b-vineeth/Prosthetic-Hand-Design/Milestone #2.docx

Milestone 2:

1. Solid Modelling of gears (may be diff. from milestone 1)

2. Print gears in Epic Lab

3. Submit photo of all gears in a JPEG file
