b-vineeth/Prosthetic-Hand-Design/Others/Prosthetic Frame Side View Dimensions.png

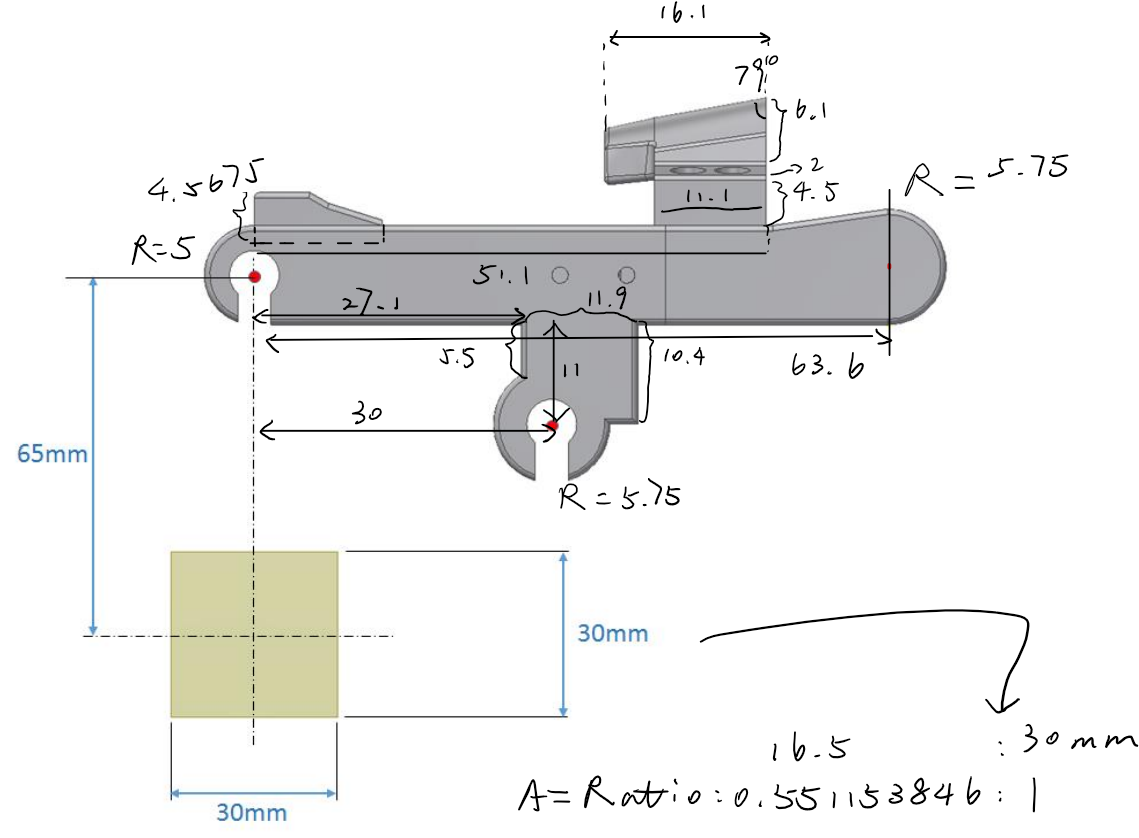
Others/Prosthetic Frame Side View Dimensions.png
