b-vineeth/Prosthetic-Hand-Design/Others/Prosthetic Frame Top View Dimensions.png

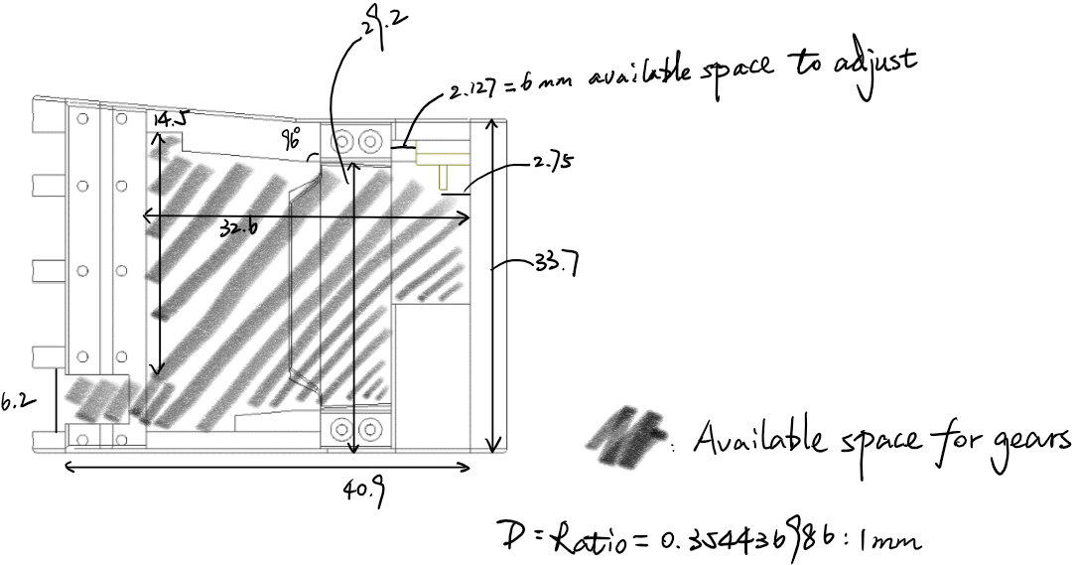
Others/Prosthetic Frame Top View Dimensions.png
