b-vineeth/Prosthetic-Hand-Design/CAD Files/90480A009_LOW-STRENGTH STEEL HEX NUT.STEP

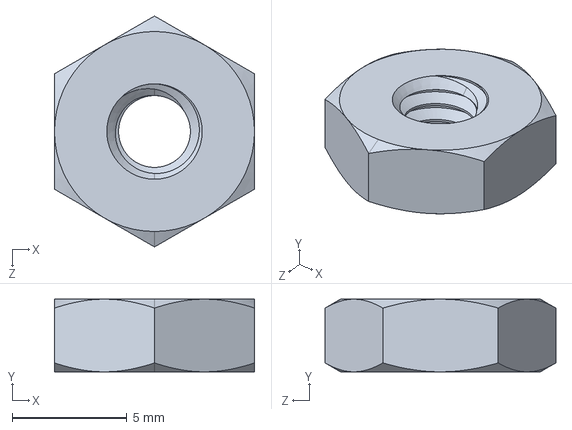
[picture p23: CAD file, 2021-11-05]
CAD Files/90480A009_LOW-STRENGTH STEEL HEX NUT.STEP
8.73 x 3.18 x 10.1 mm
