b-vineeth/Prosthetic-Hand-Design/CAD Files/91565A838_LOW-STRENGTH STEEL THREADED ROD.STEP

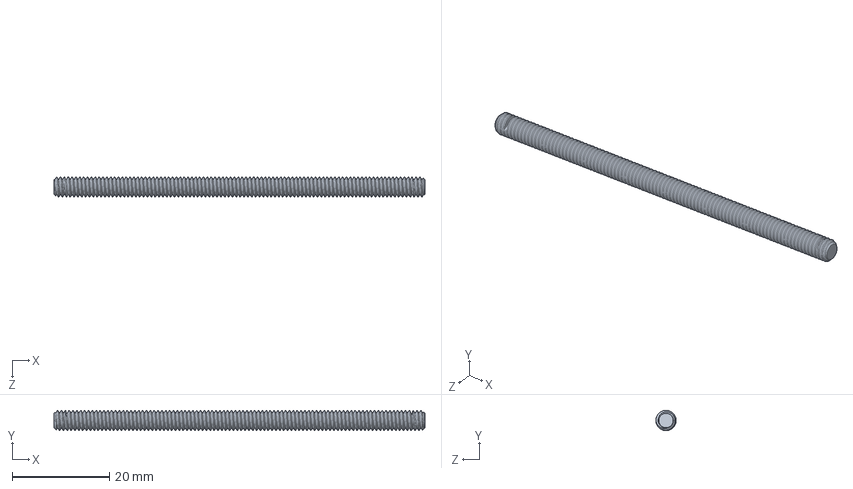
[picture p24: CAD file, 2021-11-05]
CAD Files/91565A838_LOW-STRENGTH STEEL THREADED ROD.STEP
76.2 x 4.16 x 4.17 mm
