b-vineeth/Prosthetic-Hand-Design/Drawings/2. Gears.pdf

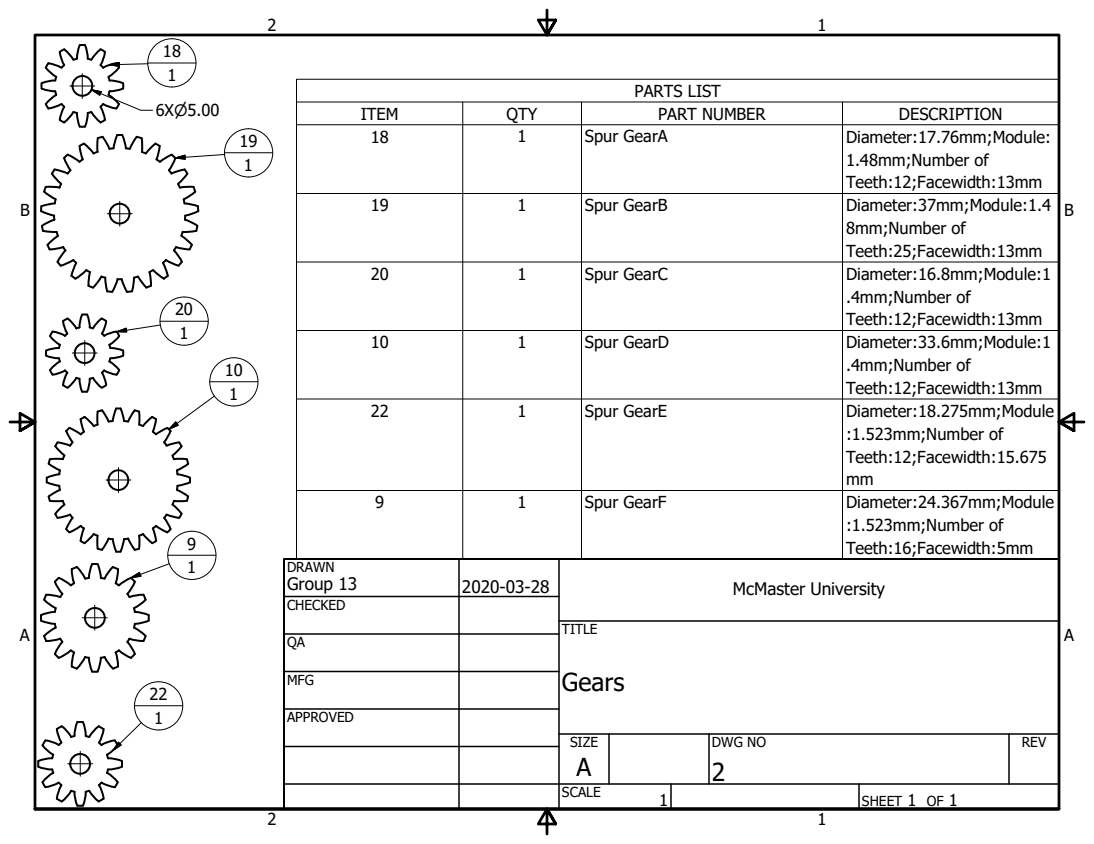
[picture p25: page 1]
PARTS LIST; ITEM; QTY; PART NUMBER; DESCRIPTION; Diameter:24.367mm;Module :1.523mm;Number of Teeth:16;Facewidth:5mm; Spur GearF; SHEET 1 OF 1; DRAWN; CHECKED; MFG; APPROVED; Group 13; DWG NO 2; TITLE; Gears; SIZE A; SCALE; McMaster University; REV

18 | 1 | Spur GearA | Diameter:17.76mm;Module: 1.48mm;Number of Teeth:12;Facewidth:13mm

19 | 1 | Spur GearB | Diameter:37mm;Module:1.4 8mm;Number of Teeth:25;Facewidth:13mm

20 | 1 | Spur GearC | Diameter:16.8mm;Module:1 .4mm;Number of Teeth:12;Facewidth:13mm

10 | 1 | Spur GearD | Diameter:33.6mm;Module:1 .4mm;Number of Teeth:12;Facewidth:13mm

22 | 1 | Spur GearE | Diameter:18.275mm;Module :1.523mm;Number of Teeth:12;Facewidth:15.675 mm
