b-vineeth/Prosthetic-Hand-Design/Drawings/3. Combined Brackets 1_3.pdf

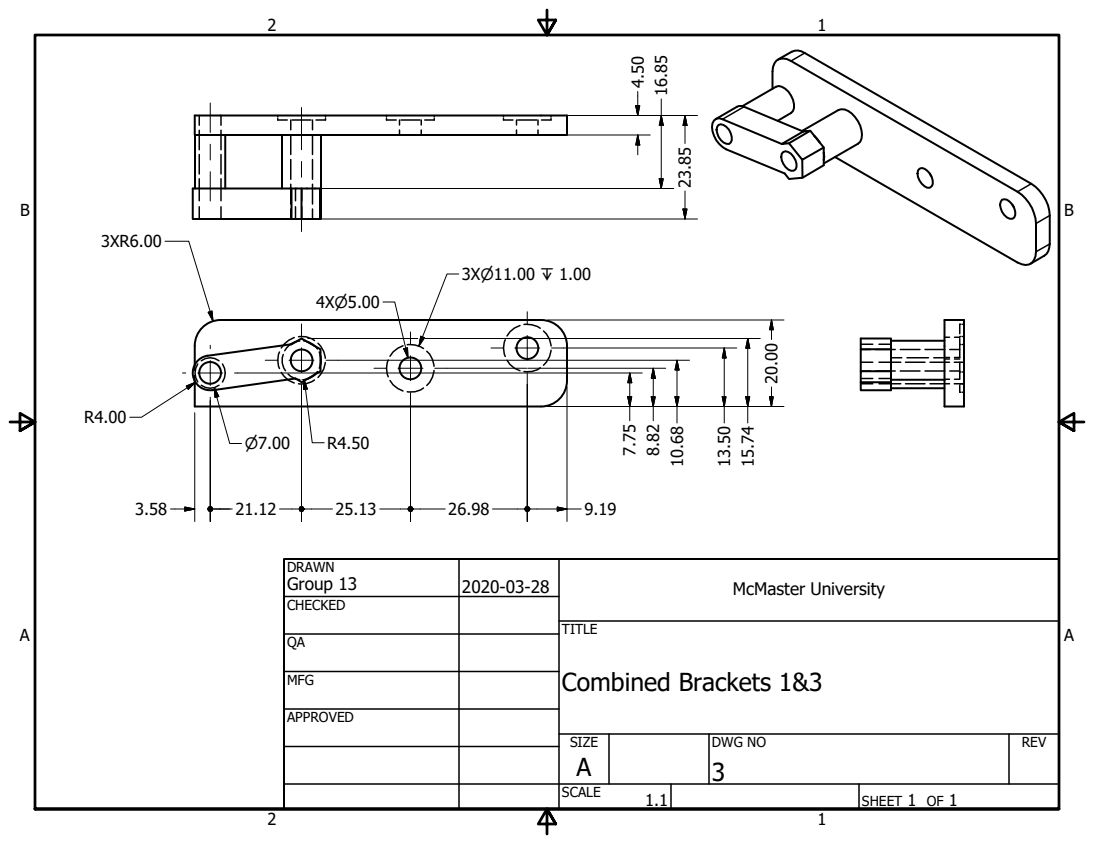
[picture p26: page 1]
DRAWN; CHECKED; MFG; APPROVED; Group 13; TITLE; Combined Brackets 1&3; McMaster University

SIZE A | | DWG NO 3 | REV

SCALE 1.1 | | SHEET 1 OF 1
