b-vineeth/Prosthetic-Hand-Design/Drawings/4. Bracket 2.pdf

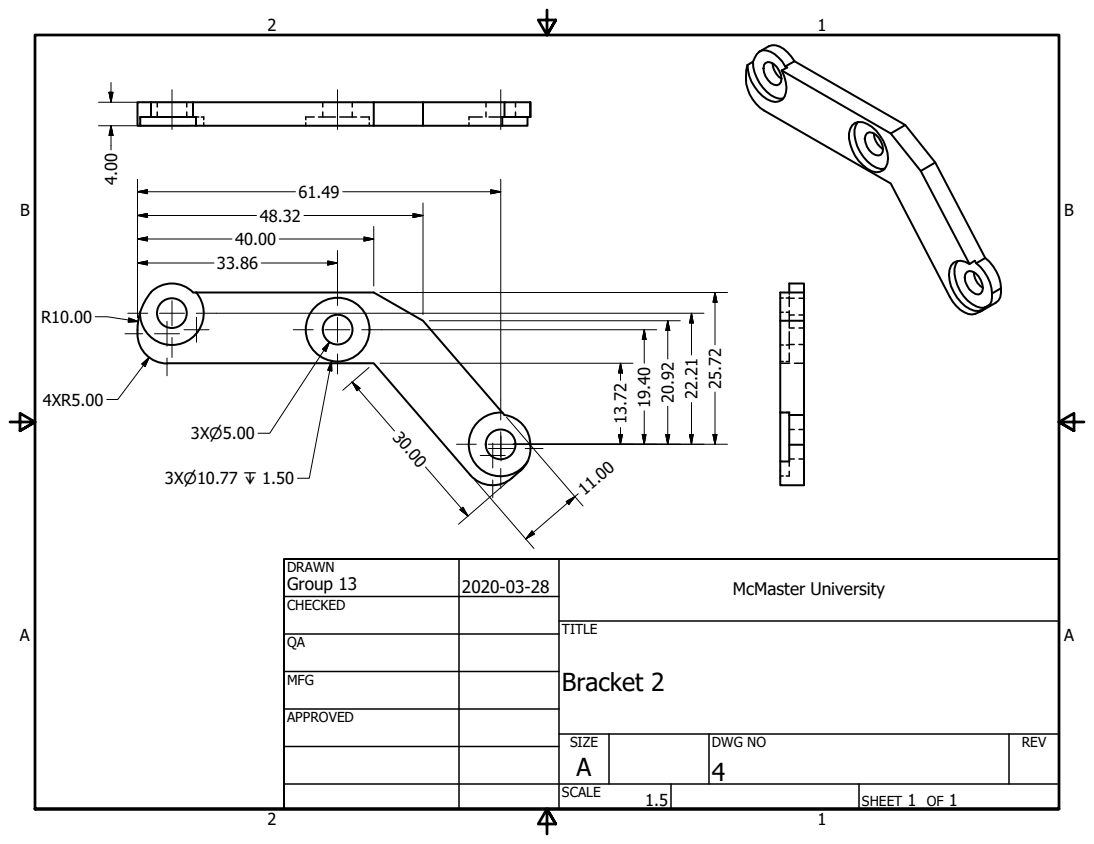
[picture p27: page 1]
SHEET 1 OF 1; DRAWN; CHECKED; MFG; APPROVED; Group 13; DWG NO 4; TITLE; Bracket 2; SIZE A; SCALE; McMaster University; REV
