b-vineeth/Prosthetic-Hand-Design/Drawings/5. Bracket 4.pdf

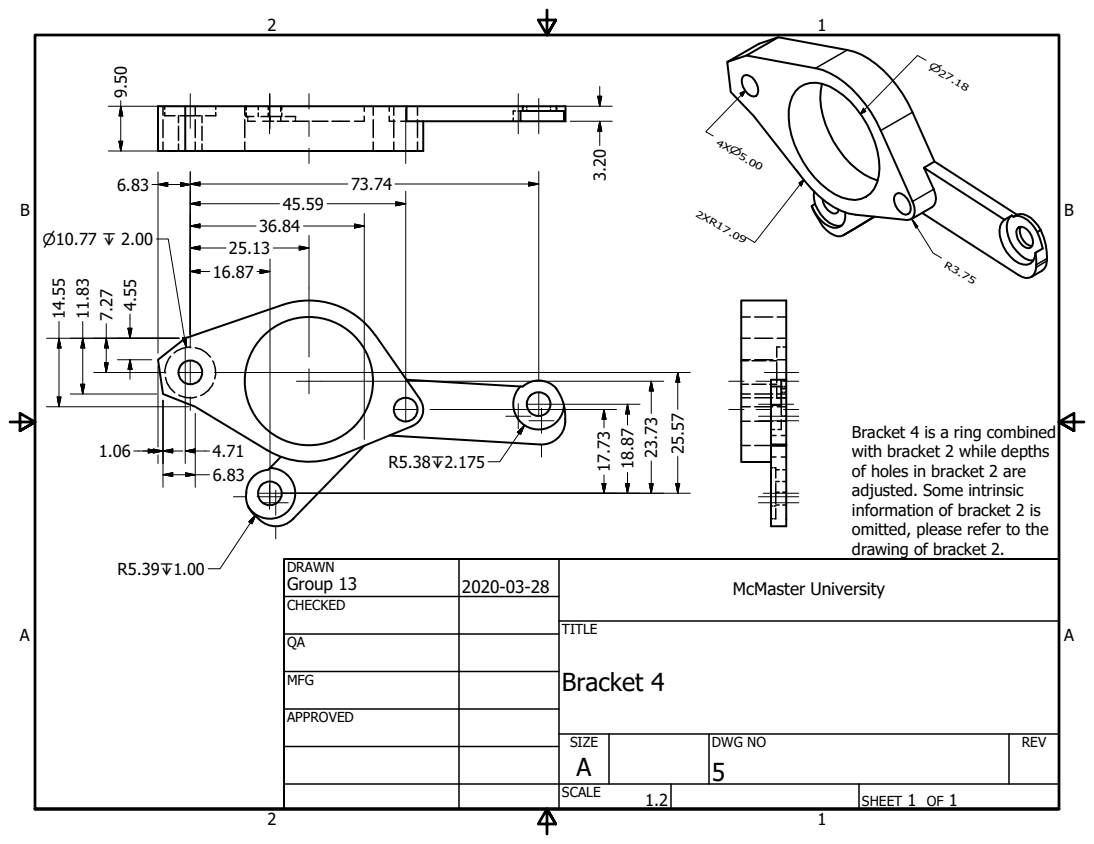
[picture p28: page 1]
SHEET 1 OF 1; DRAWN; CHECKED; MFG; APPROVED; Group 13; DWG NO 5; TITLE; Bracket 4; SIZE A; SCALE; McMaster University; REV

Bracket 4 is a ring combined
with bracket 2 while depths
of holes in bracket 2 are
adjusted. Some intrinsic
information of bracket 2 is
omitted, please refer to the
drawing of bracket 2.
