b-vineeth/Prosthetic-Hand-Design/Drawings/6. Gear G1_G2.pdf

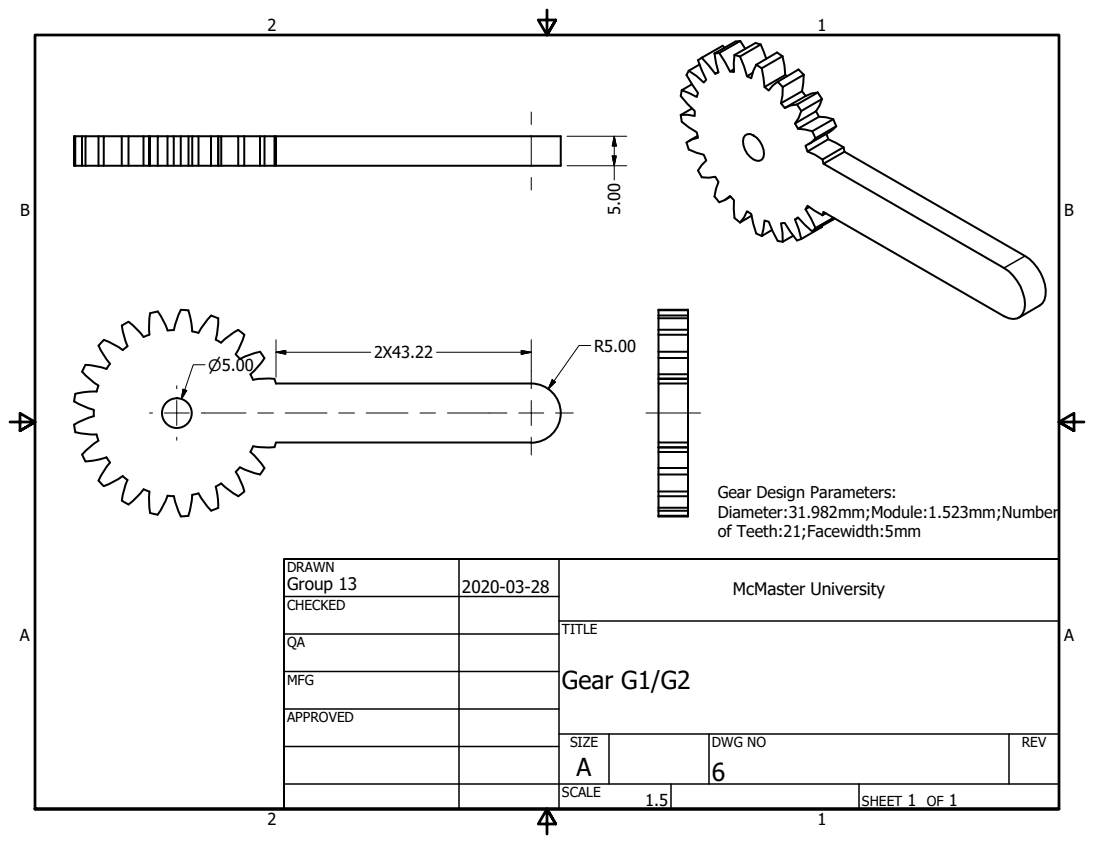
[picture p29: page 1]
SHEET 1 OF 1; DRAWN; CHECKED; MFG; APPROVED; Group 13; DWG NO 6; TITLE; Gear G1/G2; SIZE A; SCALE; McMaster University; REV

Gear Design Parameters:
Diameter:31.982mm;Module:1.523mm;Number
of Teeth:21;Facewidth:5mm
