b-vineeth/Prosthetic-Hand-Design/Drawings/Combined Brackets 1_3.pdf

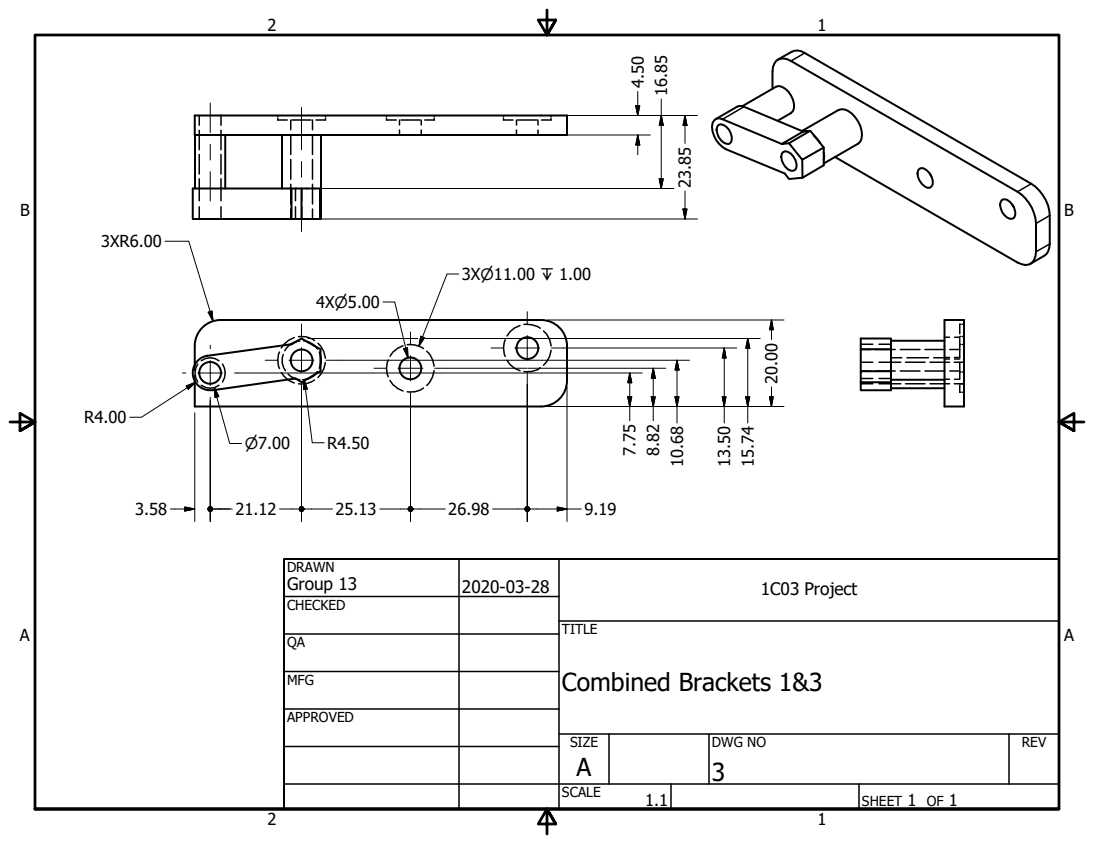
[picture p30: page 1]
DRAWN; CHECKED; MFG; APPROVED; Group 13; TITLE; Combined Brackets 1&3; 1C03 Project

SIZE A | | DWG NO 3 | REV

SCALE 1.1 | | SHEET 1 OF 1
