b-vineeth/Prosthetic-Hand-Design/Resources/Rod Dimensions.PDF

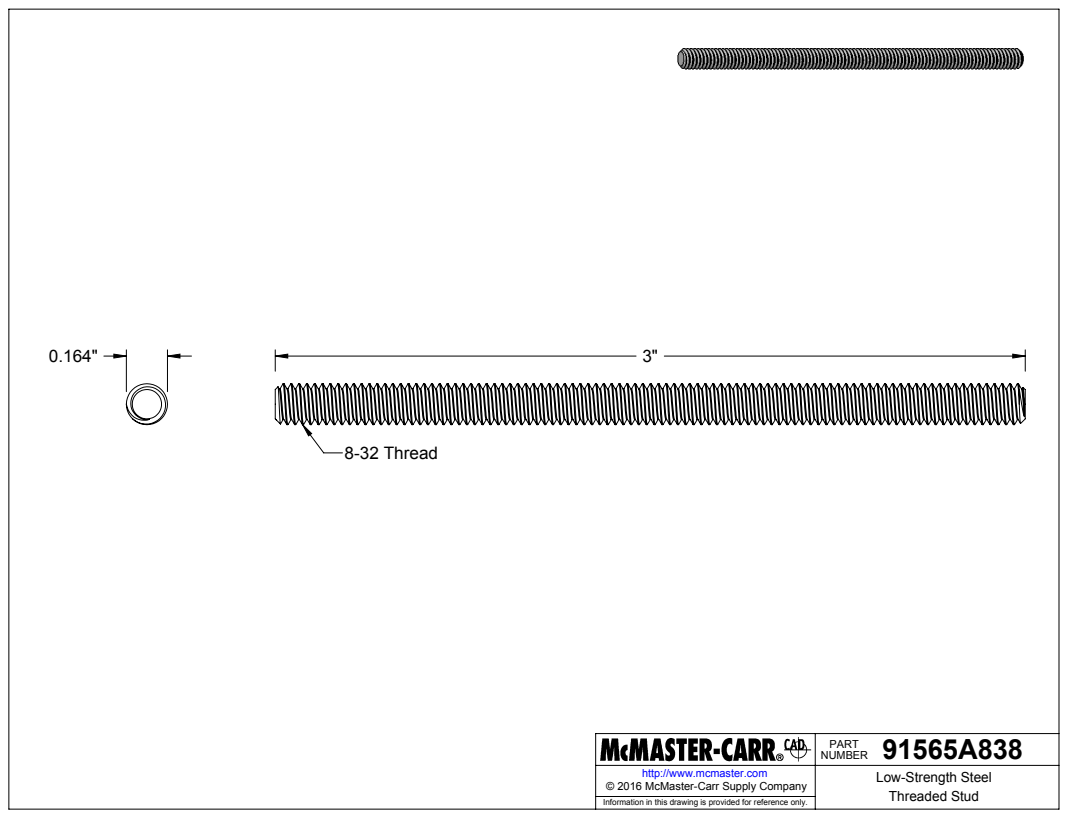
[picture p31: page 1]
8-32 Thread

91565A838 PART NUMBER

http://www.mcmaster.com | Low-Strength Steel Threaded Stud © 2016 McMaster-Carr Supply Company

Information in this drawing is provided for reference only.
