b-vineeth/Prosthetic-Hand-Design/Drawings/1. Assembly Drawing.pdf

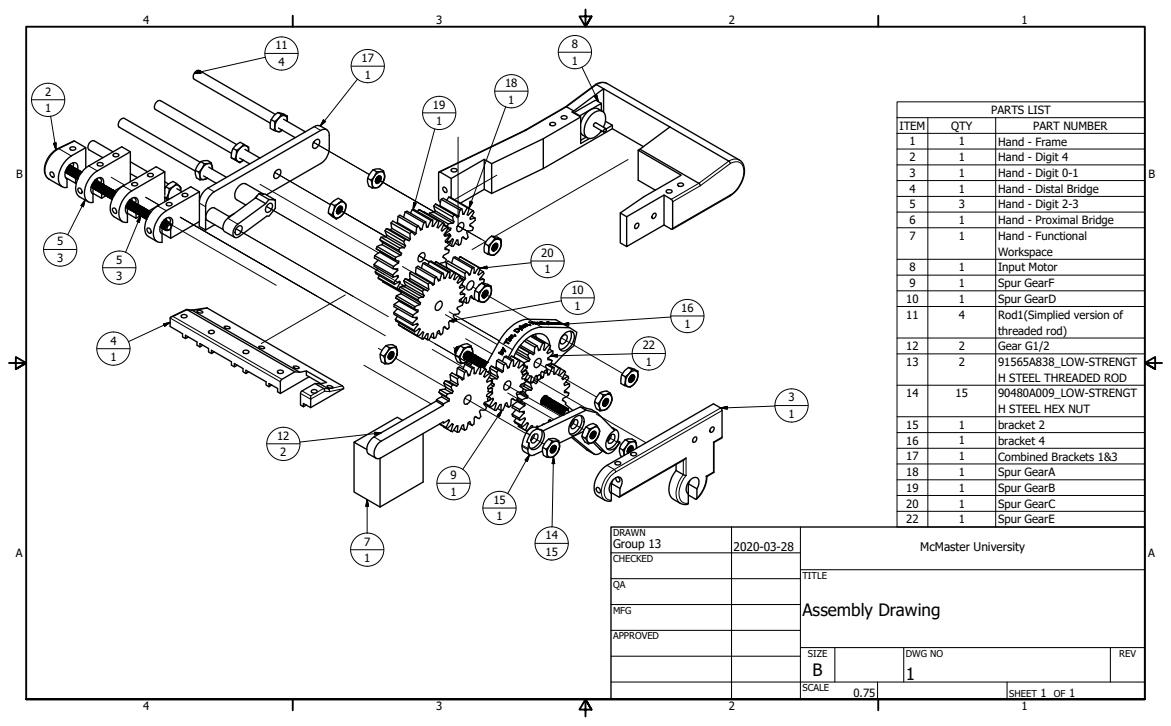
[picture p32: page 1]
bly

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

1 2 | 2 | G e a r G 1 / 2
1 3 | 2 | 9 1 5 6 5 A 8 3 8 _ L O W -S T R E N G T H S T E E L T H R E A D E D R O D

1 5 | 1 | b r a c k e t 2
1 6 | 1 | b r a c k e t 4
1 7 | 1 | C o m b i n e d B r a c k e t s 1 & 3
1 8 | 1 | S p u r G e a r A
1 9 | 1 | S p u r G e a r B
2 0 | 1 | S p u r G e a r C
