b-vineeth/Prosthetic-Hand-Design/Drawings/bracket 2.pdf

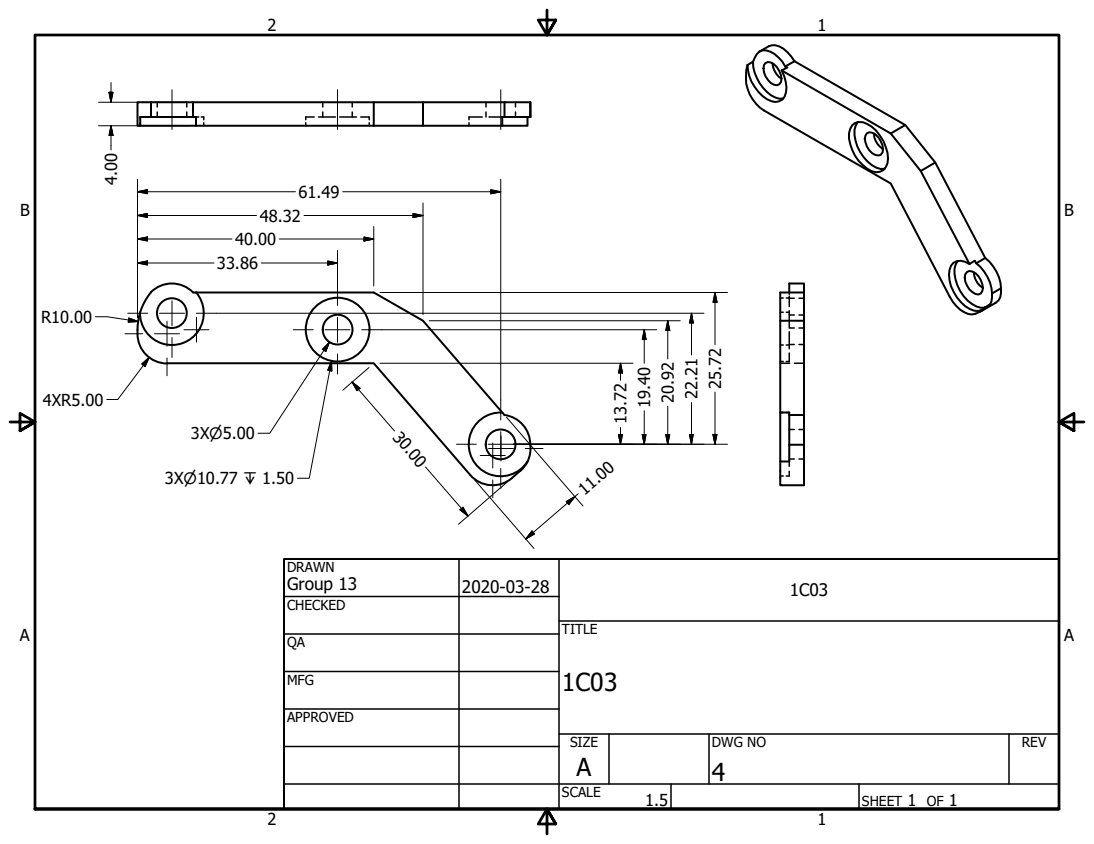
[picture p33: page 1]
SHEET 1 OF 1; DRAWN; CHECKED; MFG; APPROVED; Group 13; DWG NO 4; TITLE; SIZE A; SCALE; REV
